twneidlein/PULSAR/PULSAR Final Presentation.pdf

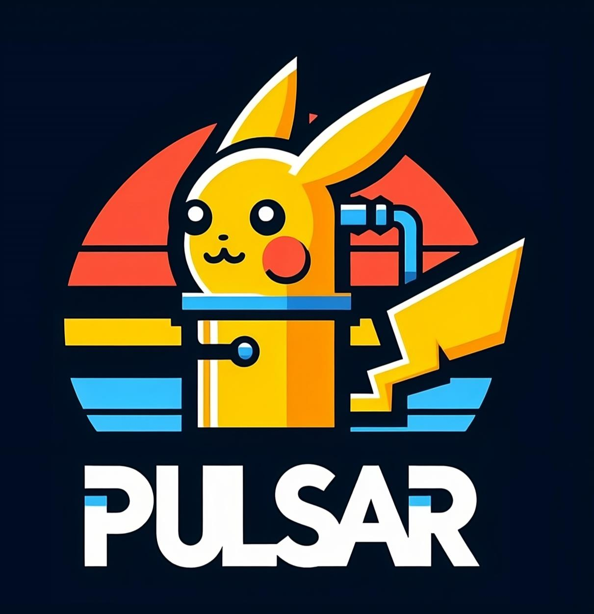
[picture p1: figure]

# PUmped Liquid System for Amateur Rockets

Project PikaPump
Final Design Review
April 23rd, 2024
James Beeman, Lamya Bhat, John Clark, Max Cohen, Fred Gouronc, Tom Neidlein

# Background

## - Liquid rockets are fed two propellants to provide thrust

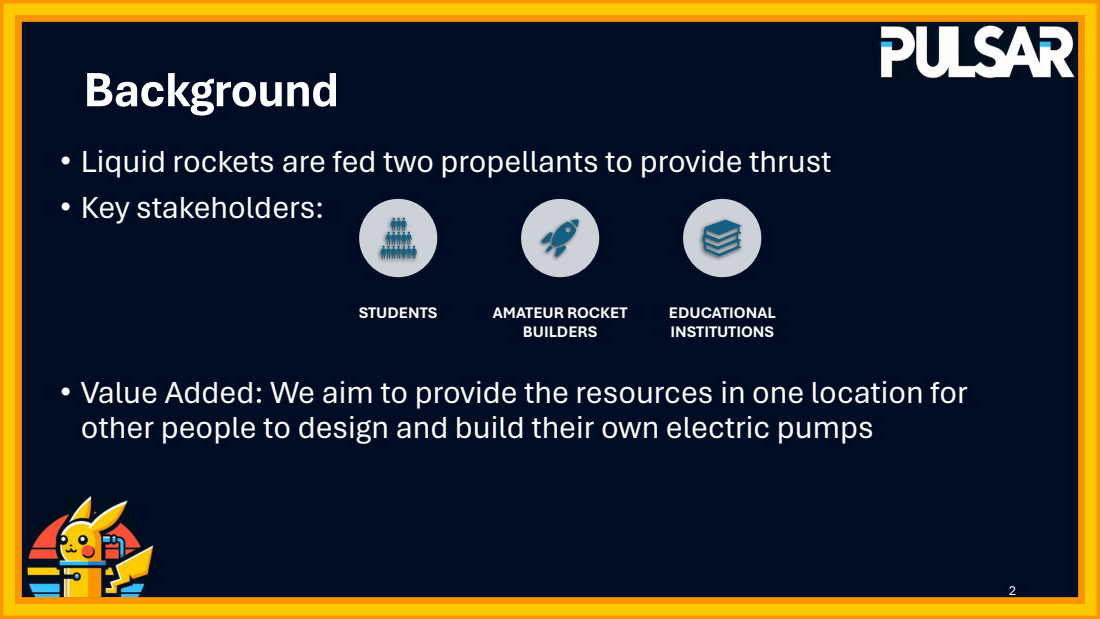
[picture p2: page 2]
• Key stakeholders:; STUDENTS; AMATEUR ROCKET; BUILDERS; EDUCATIONAL INSTITUTIONS

• Value Added: We aim to provide the resources in one location for
other people to design and build their own electric pumps

# Project Requirements

Pressure | Liquid methane pressure output of 240 psia
Flow | Liquid methane flow rate of 1.19 lbm/s
Weight | Total system weight below 12.5 lbs
Sizing | 6.6” Max diameter, 16” Maximum height
Temperature | Can withstand temperatures of -190 °C
Corrosion | Resistant to corrosive cryogenic fuels
Reusability | Will be able to operate for at least 2 flights
Measurement | Able to record outputs using sensors
Safety | Automatic and manual emergency shutoff
Test Ready | System is cryogenic test ready

# Business Case

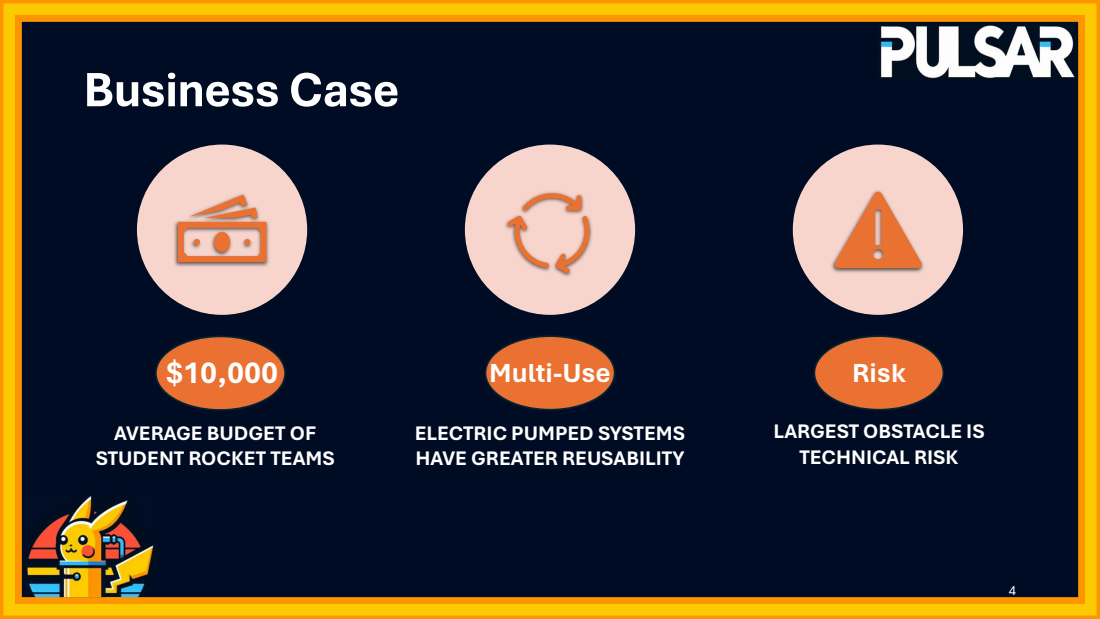
[picture p3: page 4]
Multi-Use; Risk

AVERAGE BUDGET OF
STUDENT ROCKET TEAMS

ELECTRIC PUMPED SYSTEMS
HAVE GREATER REUSABILITY

LARGEST OBSTACLE IS
TECHNICAL RISK

# CDR to FDR Model

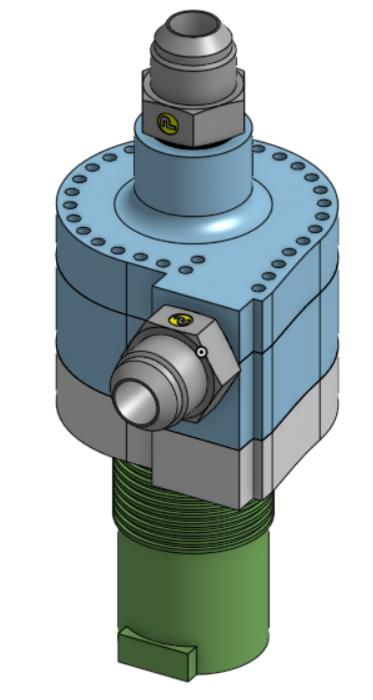
[picture p4: figure]
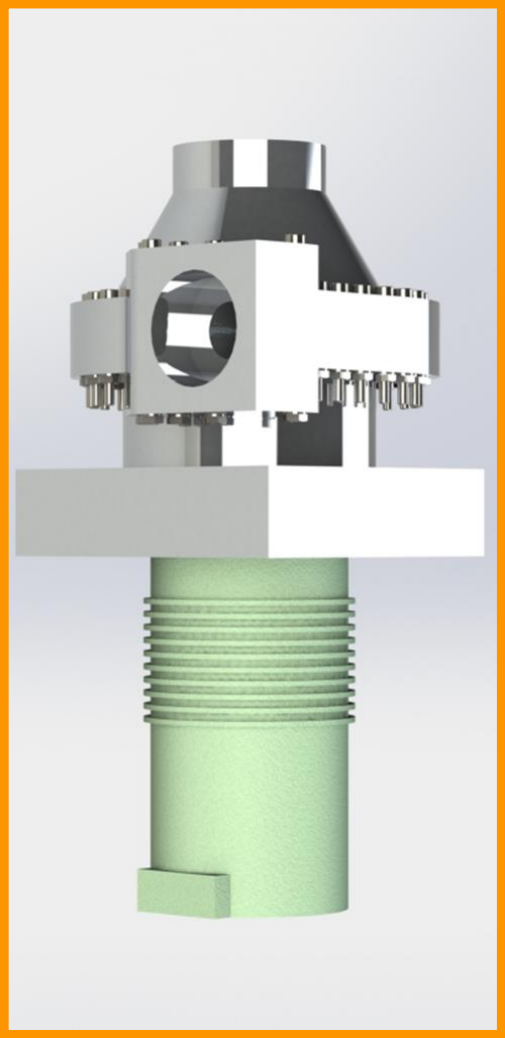
[picture p5: figure]

# Analysis Performed

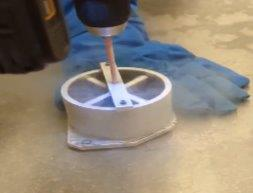
[picture p6: figure]

## - Initial CFD sims - Material Analysis tests - Driveshaft design

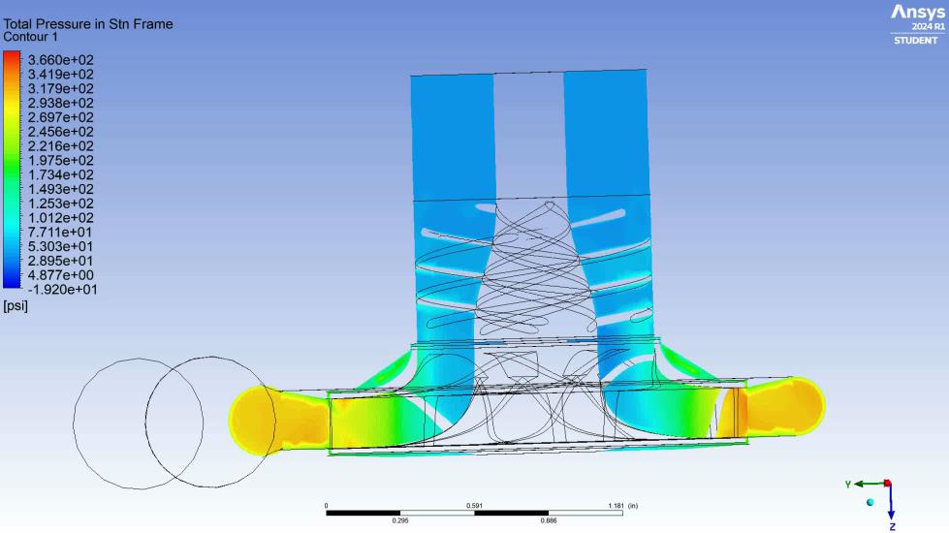
[picture p7: figure]

# Overall Assembly

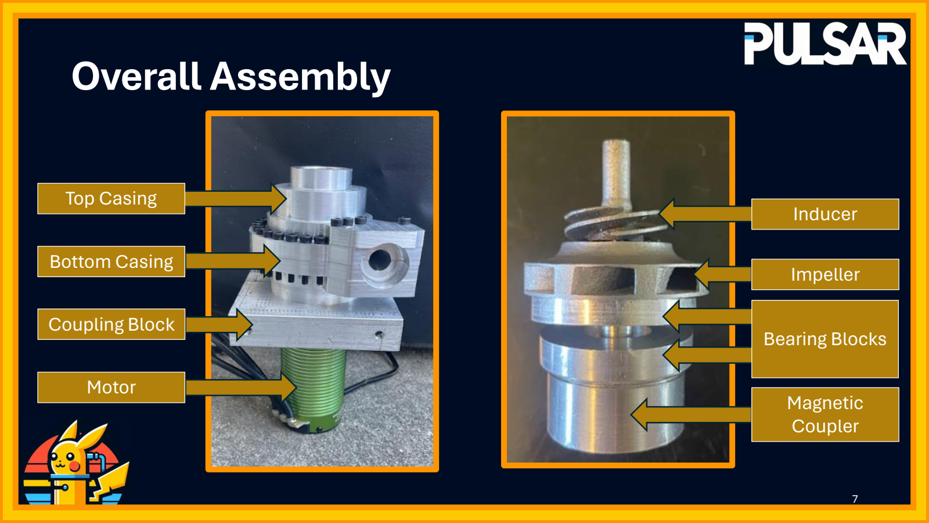
[picture p8: page 7]

Top Casing

Bottom Casing

Coupling Block

Motor
Magnetic
Coupler

Impeller

Inducer

Bearing Blocks

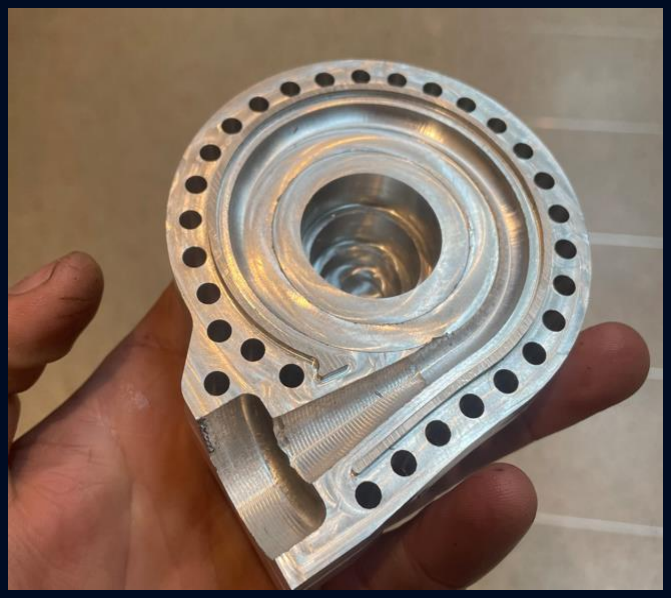
[picture p9: figure]

# Top and Bottom Casing

## - Machined on the MB-15 CNC mill

- High precision
oPurchased 1/16" endmill for seal

## - Post processing

## oBolted together and tapped oAdjusted clearances

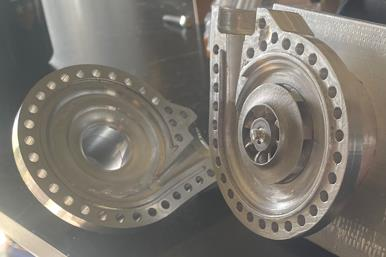
[picture p10: figure]

# Magnetic Coupler

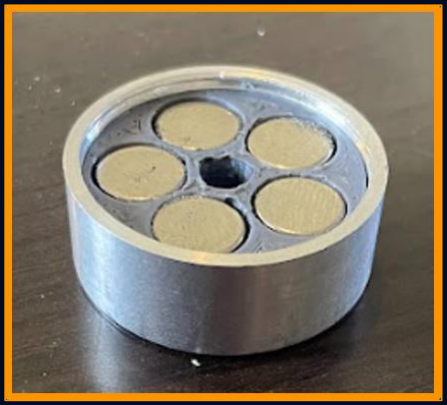
[picture p11: figure]

## - Torque transmission with no leakage - Custom-made couplers

## - Neodymium magnets packed into an aluminum case

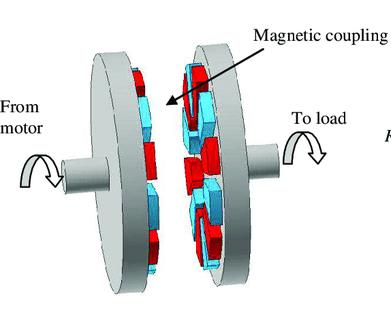
[picture p12: figure]

https://www.stanfordmagnets.com/magnetic-coupling.html

# Coupler Iteration

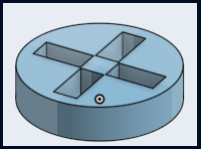
[picture p13: figure]

Stage 1

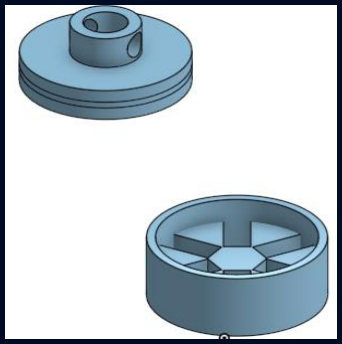
[picture p14: figure]
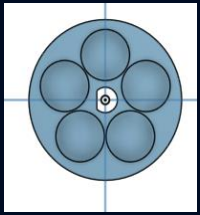
[picture p15: figure]

Stage 2- More magnets | Final Design

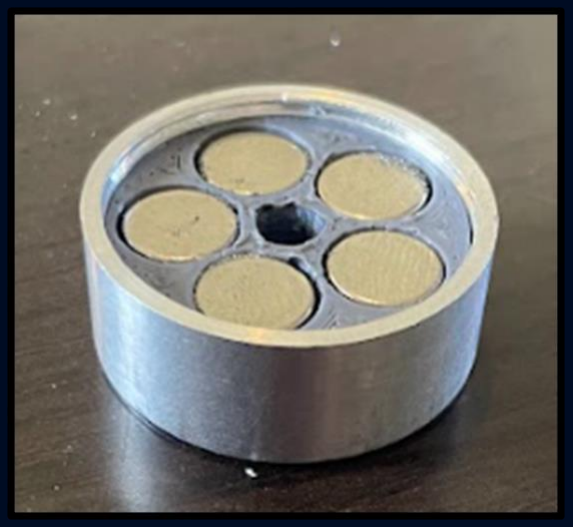
[picture p16: figure]

# Impeller and Inducer

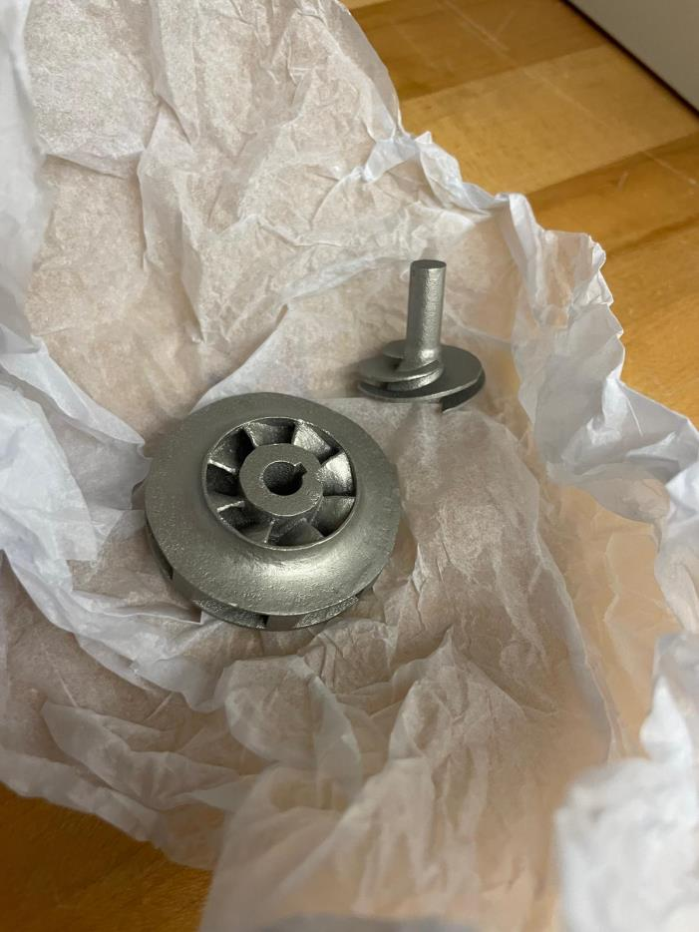
[picture p17: figure]

## - Core internal pump components - Could not be easily made in-house

## - Geometries impractical for machining

## - Parts were metal 3D printed

## oSanded down to ensure smoothness

# Other Major Components

## - Pump Driveshaft

## oConnects magnetic coupler to pump impeller oUses left hand threading to prevent unscrewing

## - Coupling Block

## - Holds magnetic coupler in place oSupports pump and motor oBolted to test setup using a welded steel H-bracket

# Drivetrain Iteration

Problem | Solution

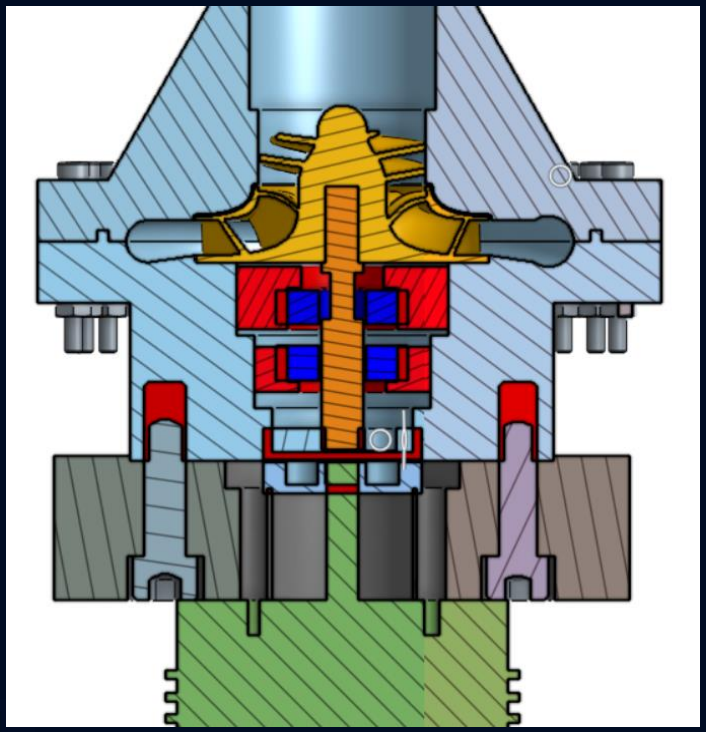
[picture p18: figure]

Coupler must be larger | Increase bearing block size
Can't assemble driveshaft | Add "coupler adaptor" part
Threads unscrew when system spins | Use left hand threading
Bolt assembly interferes w/ motor | Decrease bolt size and move outward
Bearing blocks can't be removed after press fit | Change interference fit to transition fit
Cryogenic bearings don't spin well at low RPMs | Use cheaper bearings for testing in water
Impeller/couplers bind with the casing | Increase clearances until it runs smoothly

# CFD Simulations

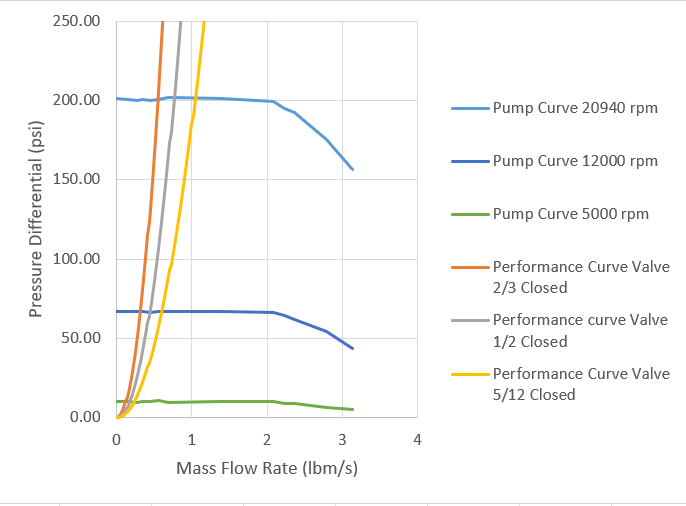
[picture p19: figure]

## - Simulate a wide range of operating conditions - Both Water and Cryogenic fluids - Need to be validated with experiments

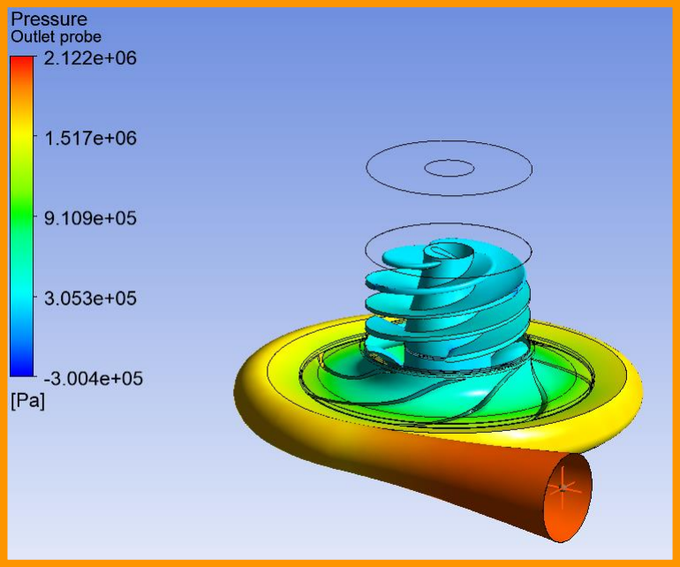
[picture p20: figure]

# Validation Plan

## Verifying the design to ensure it meets expected parameters •Create test setup •Record parameters •Data Analysis

# Data Acquisition

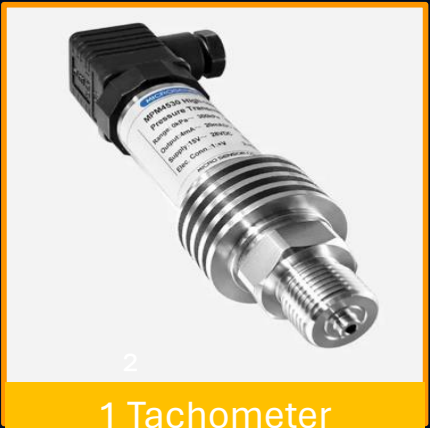
[picture p21: figure]
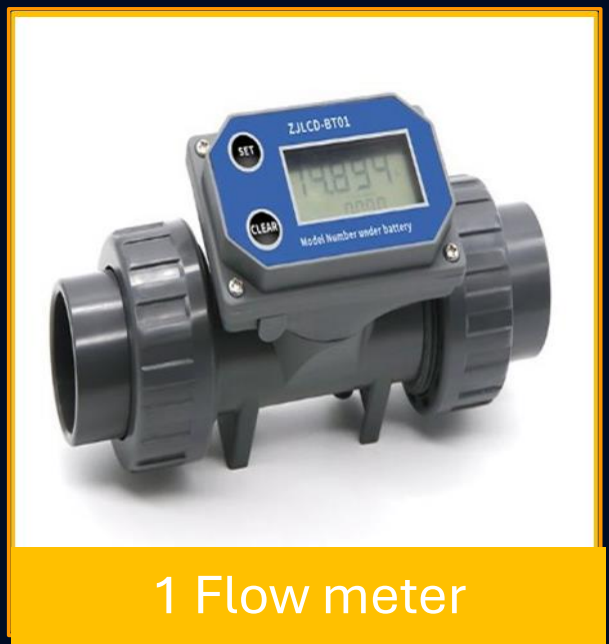
[picture p22: figure]
1 Flow meter
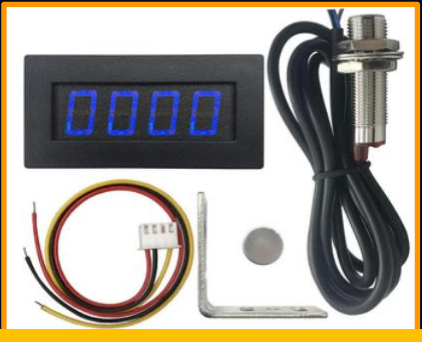
[picture p23: figure]

1 High pressure sensor | 1 Tachometer

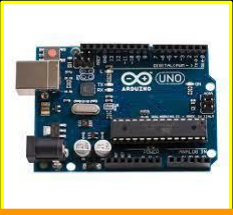
[picture p24: figure]

Arduino Uno

Gstatic (https://encrypted-tbn0.gstatic.com/shopping?usqp=CAc)
Flow (https://www.google.com/aclk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) meterd (https://www.google.com/aclk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)
Tachometer

Laptop

Arduino

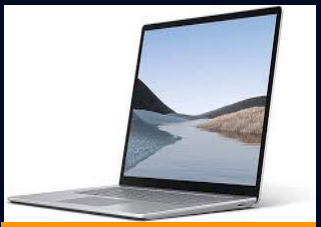
[picture p25: figure]

Laptop

# Electrical CAD

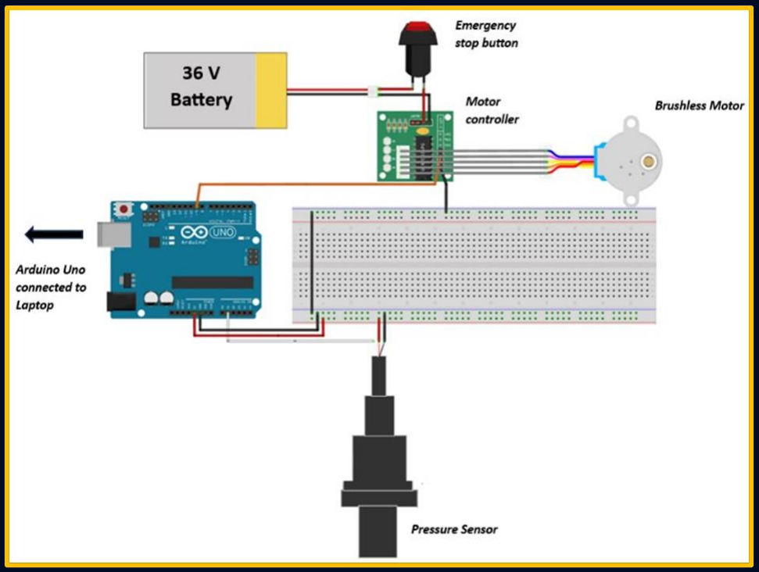
[picture p26: figure]

# Test Setup

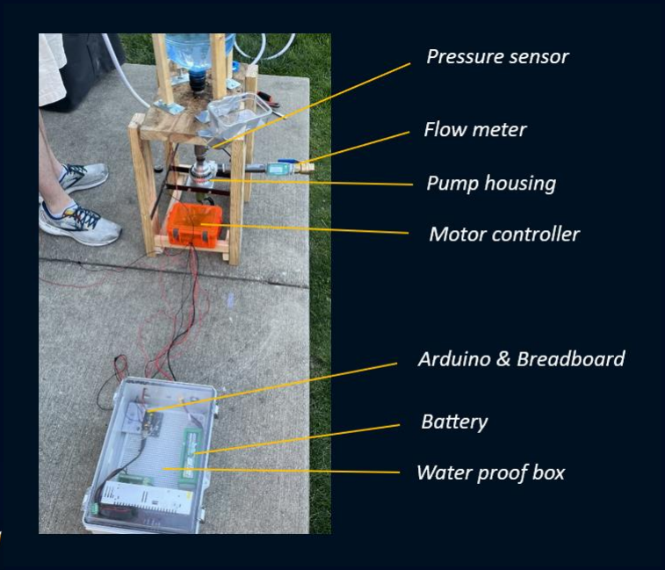
[picture p27: figure]

# Test Results

## - Ran test up ~7000 rpms - Pressure rise ~15 psi - Flow rate of 0.55 lbm/s - Any higher the coupler was not strong enough

# Results vs. Simulation

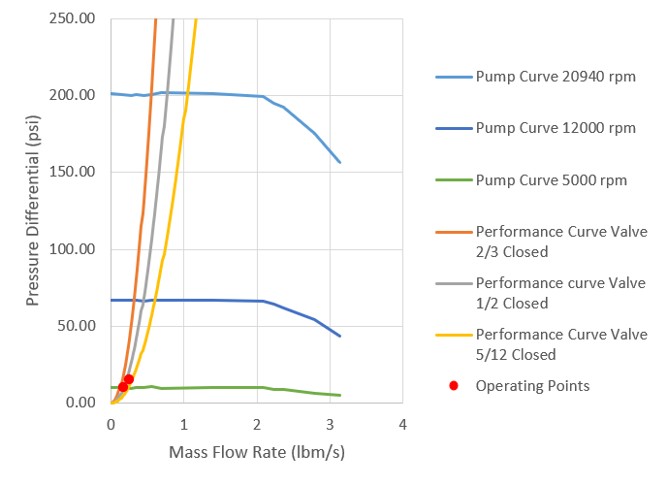
[picture p28: figure]

## - Point falls on the performance curves as predicted - Validates simulation - Would be better to test at higher rpms

# Requirements Assessment

Requirement | Description | Rqmt Met? | Reasoning
Pressure | Liquid methane pressure output of 240 psia | No | No cryo test
Flow | Liquid methane flow rate of 1.19 lbm/s | No | No cryo test
Weight | Total system weight below 12.5 lbs | Yes | ~4 lbs
Sizing | 6.6” Max diameter, 16” Maximum height | Yes | 4" Dia., 10" Tall
Temperature | Can withstand temperatures of -190 °C | Yes* | Full compliance
Corrosion | Resistant to corrosive cryogenic fuels | Yes* | Full compliance
Reusability | Will be able to operate for at least 2 flights | Yes | Multiple tests
Measurement | Able to record outputs using sensors | Yes | Data acquired
Safety | Automatic and manual emergency shutoff | Yes | E-stop works
Test Ready | System is cryogenic test ready | Yes* | Full compliance

*No tests were perfomed with cryogenics, but all components are designed for cryogenic compatibility

# Design Improvements

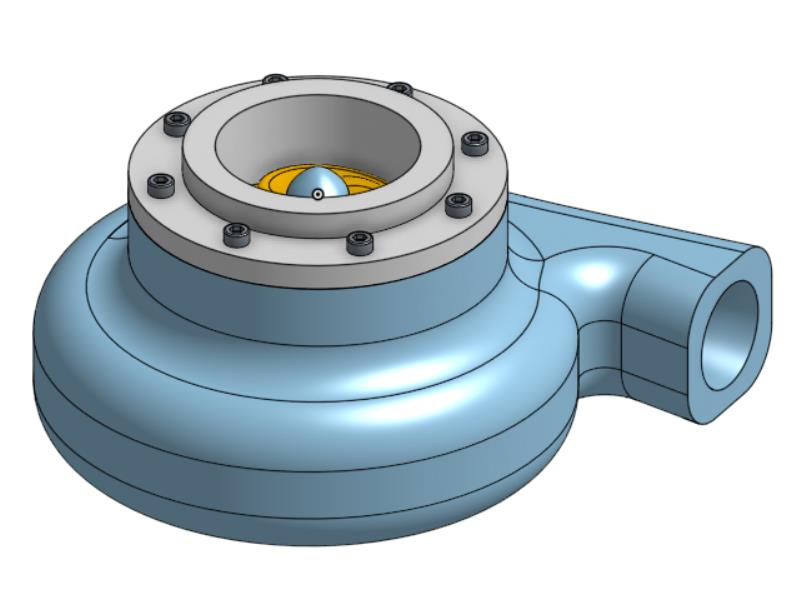
[picture p29: figure]

## - Single piece pump casing - Coupler magnet placement and strength - Better machining tolerances and finish - Sensor and data acquisition improvements

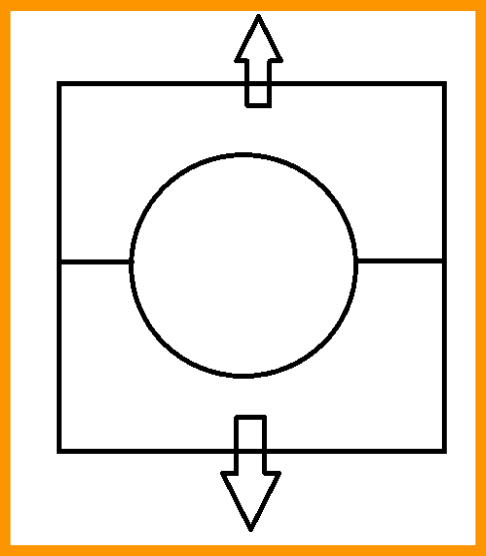
[picture p30: figure]

# Moving Forward

## - Provided roadmap, documentation, CAD, and code on GitHub so others can iterate on the design

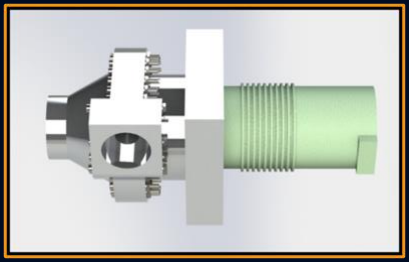
[picture p31: figure]

# Thank you!

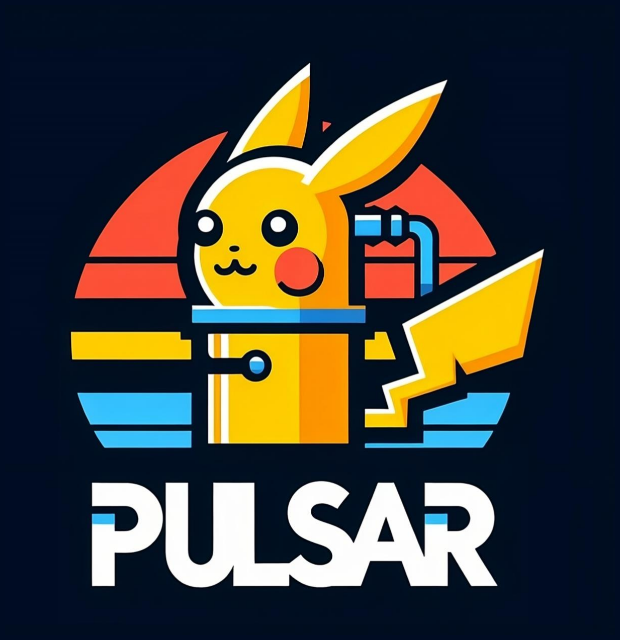
[picture p32: figure]
