twneidlein/PULSAR/BOM V2.xlsx

BILL OF MATERIALS
Team Name: Pulsar
Project Title: PikaPump
Date of V2: 2/29/24
Part No. | Part Name | Units | Quantity | Material Description | Source/Machine Tools | Catalog No. | Make(Get Free) / Buy | Unit Cost ($) | Total Price
1 | Roller Bearings | pcs | 2 | Ceramic Ball Bearings | Alpine Bearing | HYSV607P4D15 | Buy | $90.00 | $180.00
2 | 6061 Aluminium | ft | 1 | Material needed to machine pump housing and fittings (1.5"x3"x12") | Metals Depot | F41123 | Buy | $40.77 | $40.77
3 | Axpeller | pcs | 1 | Rotational impeller to be installed inside the pump structure | Cloud Craft | - | Buy | $50.00 | $50.00
4 | Static Seals | pcs | 4 | Seals for statics parts between the pump and the pipes | McMaster | - | Buy | $12.50 | $50.00
5 | Magnet Holder | pcs | 2 | Forms the base of the magnetic coupler, holds magnets in place | Machined (CNC, mill) | - | Make | $0.00 | $0.00
6 | Electric Motor | pcs | 1 | 33.6V Brushless DC motor | Castle Creations | 010-0165-02 | Buy | $389.95 | $389.95
7 | Battery | pcs | 1 | DR Lipro 62V Lithium Ion Battery | DrPower | 414230 | Buy | $89.00 | $89.00
8 | Arduino | pcs | 1 | Microcontroler used to control the motor | Persanix | Arduino Uno | Make (free) | $0.00 | $0.00
9 | M2.5 Bolts | pcs | 1 | Stainless Steel Fasteners | McMaster | 91292A012 | Make (free) | $0.00 | $0.00
10 | Top Pump Casing | pcs | 1 | Top housing component of the pump | Machined (CNC) | - | Make | $0.00 | $0.00
11 | Bottom Pump Casing | pcs | 1 | Bottom housing component of the pump, also houses magnetic coupler | Machined (CNC) | - | Make | $0.00 | $0.00
12 | Magnetic Coupler | pcs | 2 | Assemblies built to transmit torque between one another across aluminum plating | Machined (assembly) | - | Make | $0.00 | $0.00
13 | Neodymium Magnets | pcs | 48 | Magnets to be used inside the magnetic coupler | Pre-owned | - | Make (free) | $0.00 | $0.00
14 | Bearing support | pcs | 2 | Plates for bearings to be press-fit into, inserted into pump casing | Machined (CNC, lathe) | - | Make | $0.00 | $0.00
15 | Drive Shaft | pcs | 2 | Transmits power from motor to axpeller | Machined (lathe) | - | Make | $0.00 | $0.00
16 | Pump Inlet Line | pcs | 1 | Transfers liquid from upper reservoir to pump | Machined (mill, pipe threads) | - | Make | $0.00 | $0.00
17 | Volute Outlet | pcs | 1 | Transfers liquid from pump to lower reservoir | Machined (CNC, pipe threads) | - | Make | $0.00 | $0.00
18 | Upper Reservoir | pcs | 1 | Container to hold liquid before moving through pump | Pre-owned | - | Make (free) | $0.00 | $0.00
19 | Lower Reservoir | pcs | 1 | Container to eject pump output into | Pre-owned | - | Make (free) | $0.00 | $0.00
20 | Ball Valve | pcs | 4 | Valve to isolate pump from upper reservoir | McMaster | 47865K24 | Buy | $18.23 | $72.92
21 | AN Fittings | pcs | 4 | Fitting for fluid inlet and outlet | anhosefittings | -8AN O-Ring | Buy | $3.90 | $15.60
Total Project cost |  |  |  |  |  |  |  |  | $888.24
